charlesrg/powerwheels/esc.kicad_sch

## KiCad design esc.kicad_sch (2022-05-20)

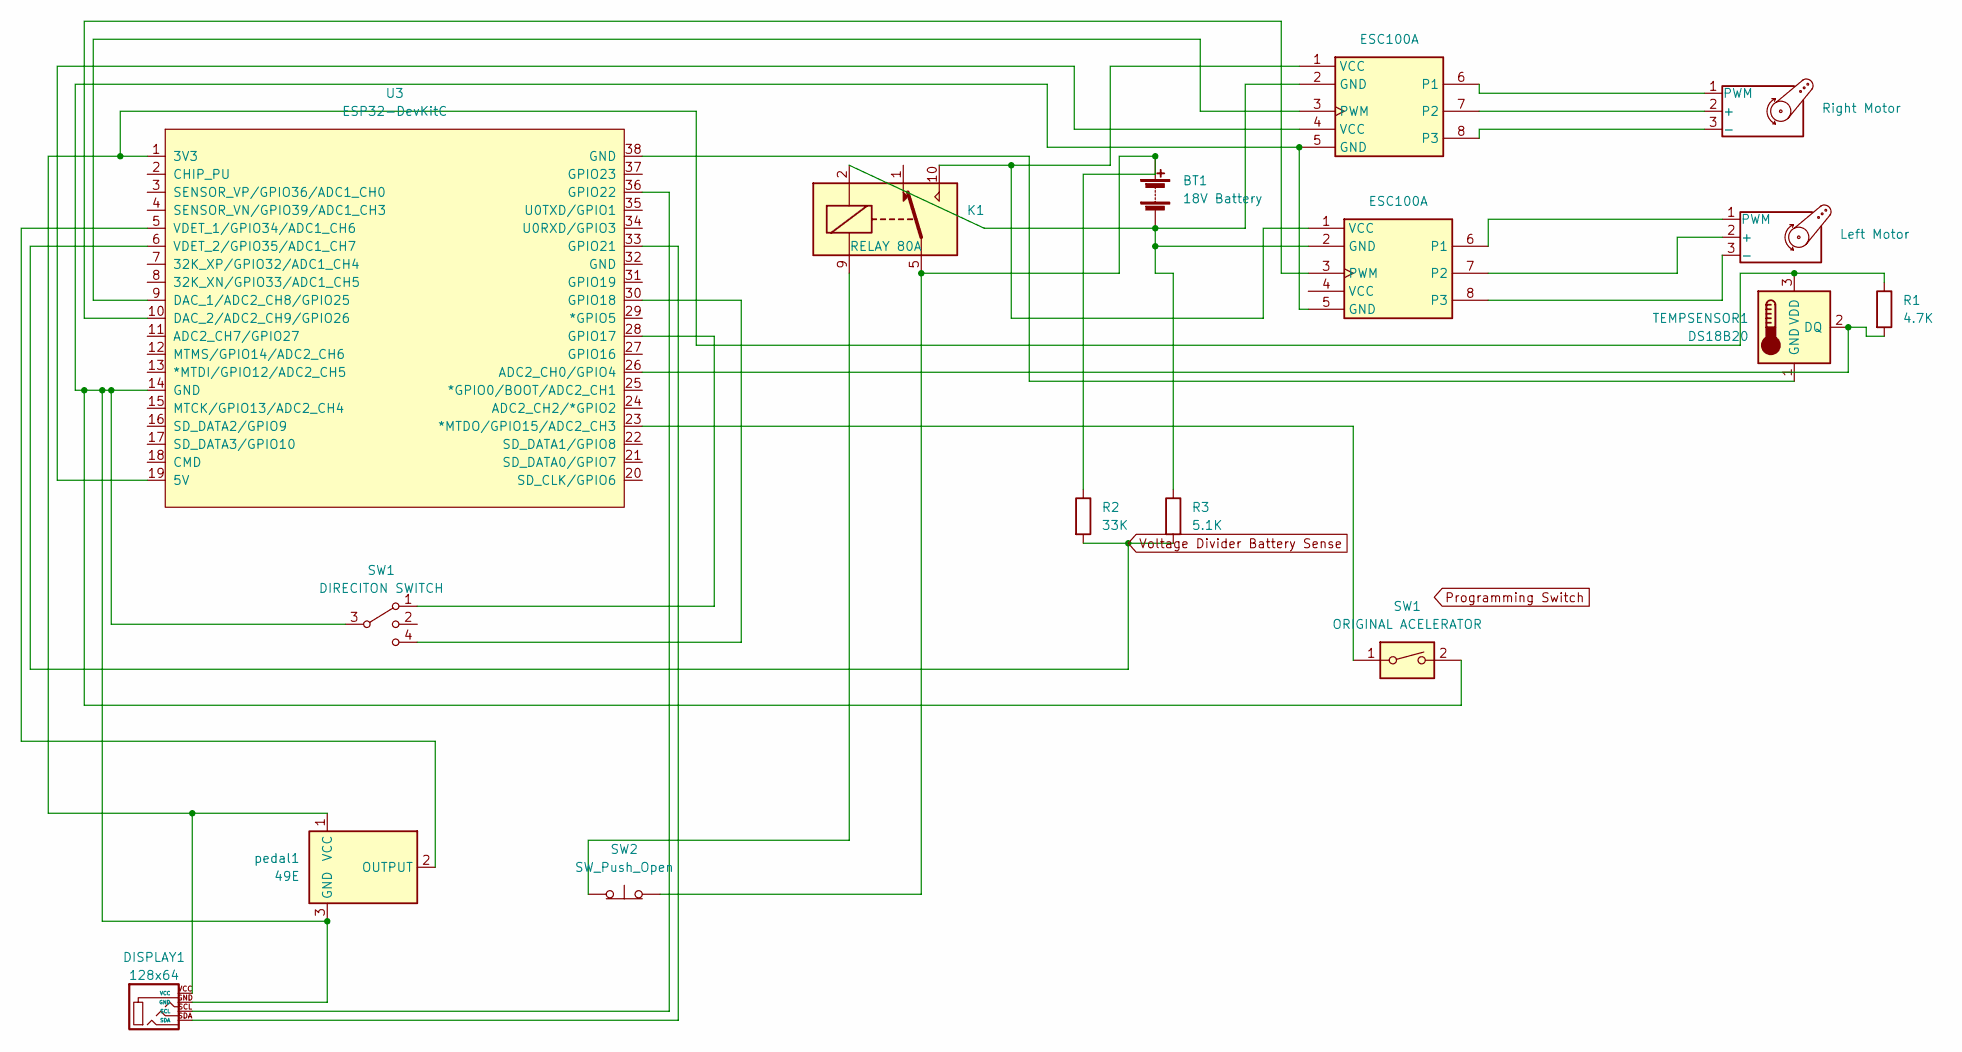
[picture p1: schematic esc.kicad_sch]

Parts:
BT1: 18V Battery
DISPLAY1: 128x64
K1: RELAY 80A; Relay_SPDT_Omron_G5V-1
M1: Right Motor
M2: Left Motor
R1: 4.7K
R2: 33K
R3: 5.1K
SW1: ORIGINAL ACELERATOR
SW2: SW_Push_Open
TEMPSENSOR1: DS18B20; TO-92_Inline
U1, U2: ESC100A
U3: ESP32-DevKitC
pedal1: 49E; SOT-23

Connections:
unnamed: BT1.1 (+), K1.5, K1.6, R2.1, SW2.2 (B)
unnamed: BT1.2 (-), K1.2, R3.1, U1.2 (GND), U2.2 (GND)
unnamed: DISPLAY1.GND, SW1.2, SW1.3, U1.5 (GND), U2.5 (GND), U3.14 (GND), pedal1.3 (GND)
unnamed: DISPLAY1.SCL, U3.36 (GPIO22)
unnamed: DISPLAY1.SDA, U3.33 (GPIO21)
unnamed: DISPLAY1.VCC, R1.1, TEMPSENSOR1.3 (VDD), U3.1 (3V3), pedal1.1 (VCC)
unnamed: K1.9, SW2.1 (A)
unnamed: K1.10, U1.1 (VCC), U2.1 (VCC)
unnamed: M1.1 (PWM), U1.6 (P1)
unnamed: M1.2 (+), U1.7 (P2)
unnamed: M1.3 (-), U1.8 (P3)
unnamed: M2.1 (PWM), U2.6 (P1)
unnamed: M2.2 (+), U2.7 (P2)
unnamed: M2.3 (-), U2.8 (P3)
unnamed: R1.2, TEMPSENSOR1.2 (DQ), U3.26 (ADC2_CH0/GPIO4)
unnamed: SW1.1, U3.23 (*MTDO/GPIO15/ADC2_CH3), U3.28 (GPIO17)
unnamed: SW1.4, U3.30 (GPIO18)
unnamed: TEMPSENSOR1.1 (GND), U3.38 (GND)
unnamed: U1.3 (PWM), U3.9 (DAC_1/ADC2_CH8/GPIO25)
unnamed: U1.4 (VCC), U3.19 (5V)
unnamed: U2.3 (PWM), U3.10 (DAC_2/ADC2_CH9/GPIO26)
unnamed: U3.5 (VDET_1/GPIO34/ADC1_CH6), pedal1.2 (OUTPUT)
Voltage Divider Battery Sense: R2.2, R3.2, U3.6 (VDET_2/GPIO35/ADC1_CH7)
