charlesrg/powerwheels/(commit log)

2022-05-20 Add files via upload
    Kicad FIles
    [esc.kicad_sch]
2022-05-23 Update esp32.ino
    new version now using both cores of the ESP32
